FacileStudio/Pastille/dist/fab/bom.csv

Comment | Designator | Footprint | LCSC Part # | Manufacturer Part
ESP32-S3-MINI-1-N4R2 | U_ESP32_S3 | custom | C3013941 | ESP32-S3-MINI-1-N4R2
10kΩ | R_BOOT R_CHG_PU R_PU | res0402 | C25744 | RC0402FR-0710KL
1uF | C_HAP C_HAP_REG C_LCD C_MIC_BULK C_PU | cap0402_nonpolarized | C52923 | GRM155R61A105KE15D
100nF | C_AMP_HF C_BATT_SENSE C_MCU_1 C_MIC | cap0402_nonpolarized | C307331 | GRM155R71C104KA88D
22uF | C_MCU_BULK | cap0603_nonpolarized |  | GRM188R61A226ME15D
TYPE-C 16PIN 2MD(073) | J_USB | custom | C2765186 | TYPE-C 16PIN 2MD(073)
SMF5.0A | D_TVS | smf |  | SMF5.0A
5.1kΩ | R_CC1 R_CC2 | res0402 | C25905 | RC0402FR-075K1L
USBLC6-2SC6 | U_ESD | sot23_6 | C7519 | USBLC6-2SC6
TP4056-42-ESOP8 | U_CHG | soic8_thermalpad2.4x3.1mm | C16581 | TP4056-42-ESOP8
10uF | C_AMP C_BAT C_VBUS | cap0402_nonpolarized |  | GRM155R60J106ME15D
18kΩ | R_PROG | res0402 | C138044 | RC0402FR-0718KL
SM02B-SRSS-TB(LF)(SN) | J_BAT | custom | C160402 | SM02B-SRSS-TB(LF)(SN)
1MΩ | R_BATT_BOT R_BATT_TOP | res0402 |  | RC0402FR-071ML
1N5819WS | D_SYS | sod323 |  | 1N5819WS
AO3401A | Q_PATH | sot23 | C15127 | AO3401A
100kΩ | R_AMP_SD R_BL_PD R_MIC_PD R_PATH_G | res0402 |  | RC0402FR-07100KL
4.7uF | C_SYS | cap0603_nonpolarized | C19666 | GRM188R61A475KE15D
RT9080-33GJ5 | U_LDO | sot23_5 | C841192 | RT9080-33GJ5
10uF | C_LDO_OUT | cap0603_nonpolarized | C19702 | GRM188R61A106KE69D
SPH0645LM4H-B | U_MIC | custom |  | SPH0645LM4H-B
MAX98357AETE+ | U_AMP | qfn16_w3.8_h3.8_p0.5_pw0.25_pl0.8_thermalpad1.23x1.23mm |  | MAX98357AETE+
FH34SRJ-12S-0.5SH(50) | J_LCD | custom | C424659 | FH34SRJ-12S-0.5SH(50)
AO3400A | Q_BL | sot23 | C20917 | AO3400A
10Ω | R_BL | res0402 |  | RC0402FR-0710RL
510Ω | R_TOUCH | res0402 |  | RC0402FR-07510RL
DRV2605LDGSR | U_HAP | msop10 |  | DRV2605LDGSR
4.7kΩ | R_SCL R_SDA | res0402 | C25900 | RC0402FR-074K7L
