FacileStudio/Pastille/bodies/lra.step

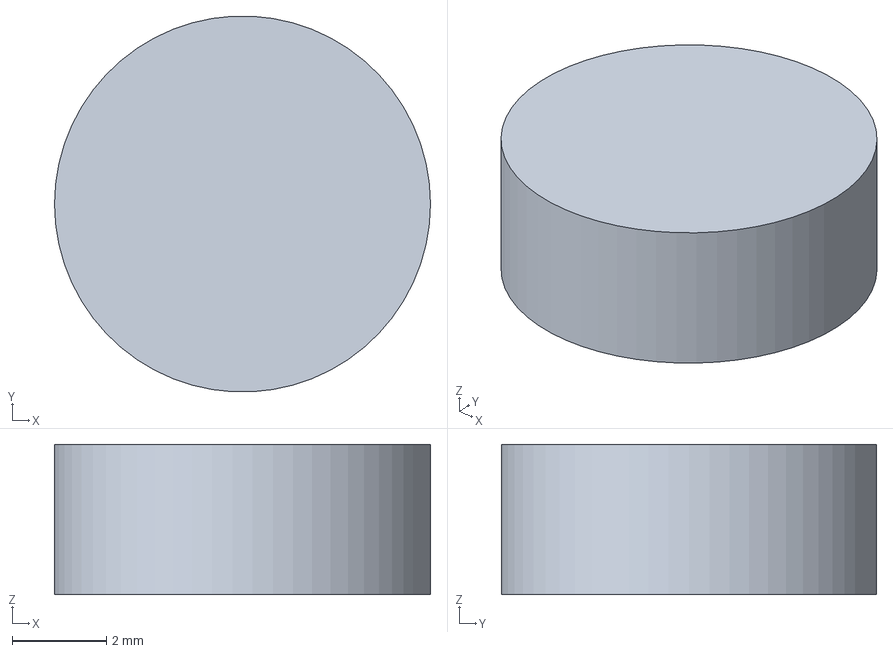
[picture p4: CAD file, 2026-11-06]
bodies/lra.step
8.00 x 7.99 x 3.20 mm
