FacileStudio/Pastille/dist/cad/board.step

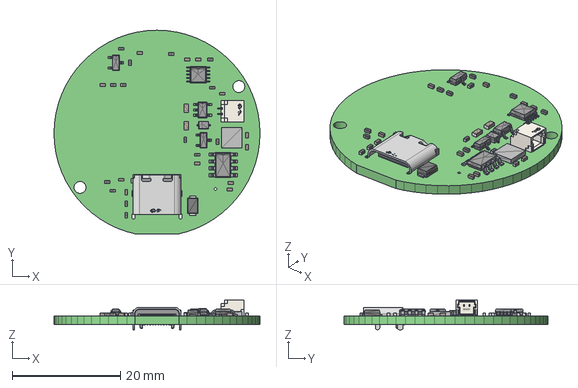
[picture p5: CAD file, 2026-11-04]
dist/cad/board.step
38.0 x 37.6 x 5.48 mm
