FacileStudio/Pastille/bodies/front_bezel.step

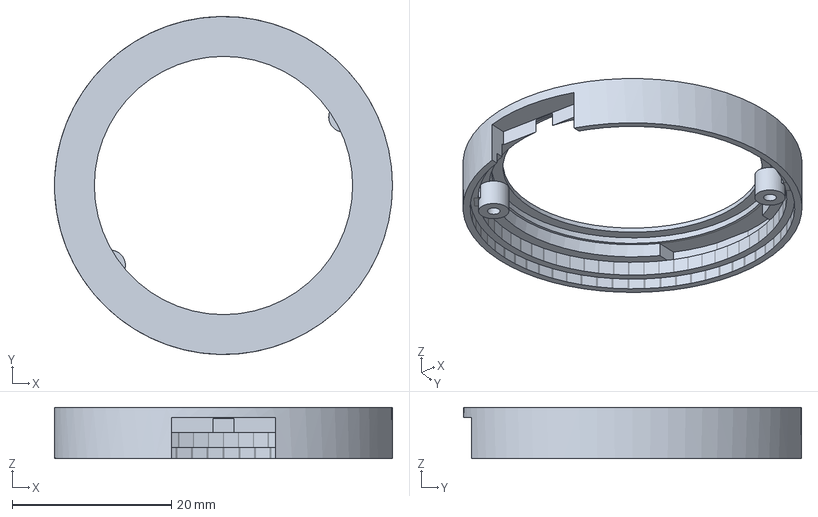
[picture p6: CAD file, 2026-11-06]
bodies/front_bezel.step
42.4 x 42.4 x 6.40 mm
