FacileStudio/Pastille/bodies/lcd.step

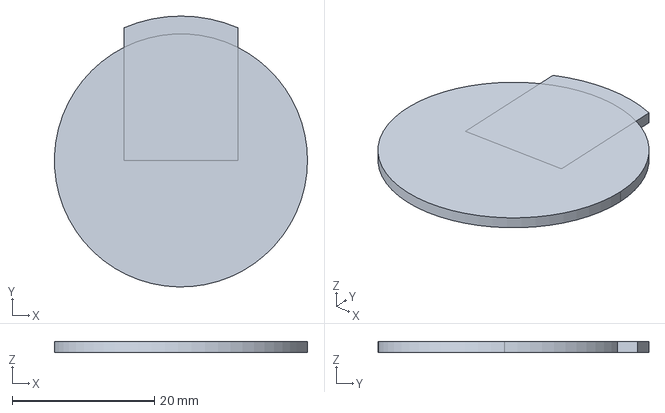
[picture p7: CAD file, 2026-11-06]
bodies/lcd.step
35.6 x 38.1 x 1.50 mm
