FacileStudio/Pastille/bodies/battery.step

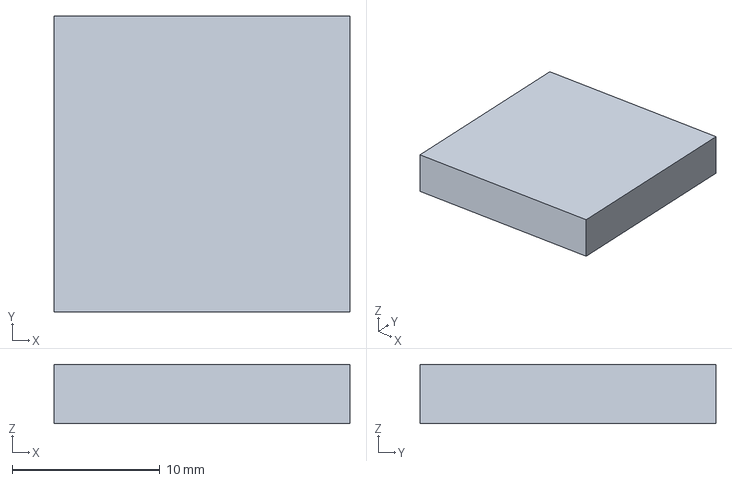
[picture p8: CAD file, 2026-11-06]
bodies/battery.step
20.0 x 20.0 x 4.00 mm
