FacileStudio/Pastille/bodies/back_shell.step

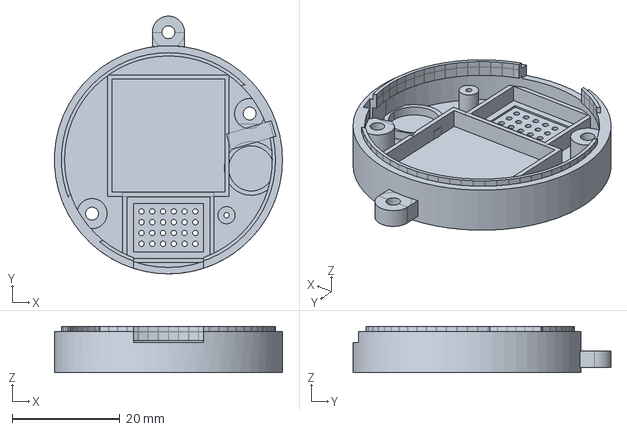
[picture p9: CAD file, 2026-11-06]
bodies/back_shell.step
42.4 x 47.9 x 8.60 mm
