FacileStudio/Pastille/bodies/speaker.step

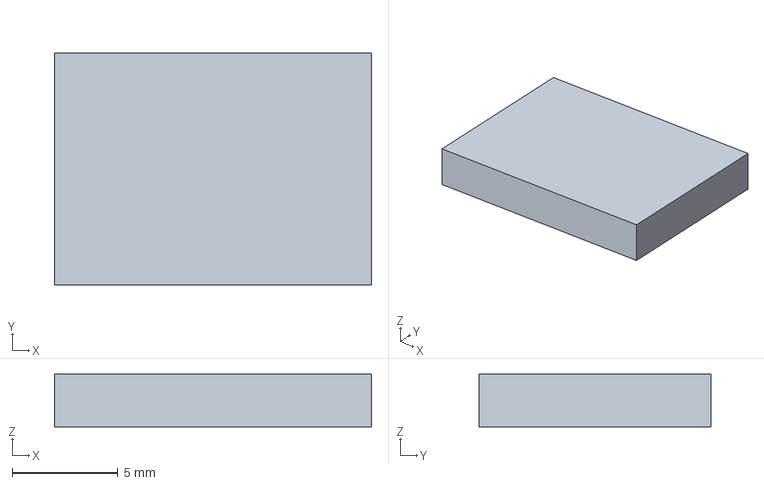
[picture p10: CAD file, 2026-11-06]
bodies/speaker.step
15.0 x 11.0 x 2.50 mm
