FacileStudio/Pastille/bodies/lens.step

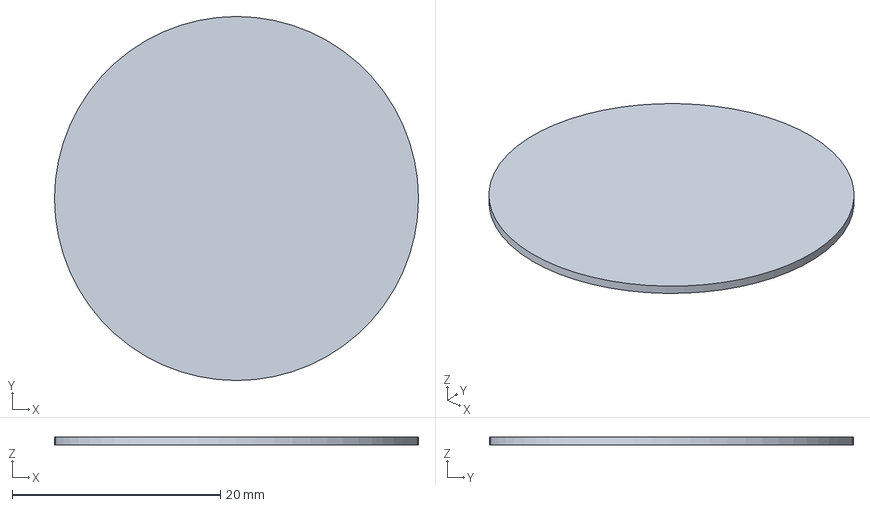
[picture p11: CAD file, 2026-11-06]
bodies/lens.step
35.0 x 35.0 x 0.8 mm
