FacileStudio/Pastille/(list of files, cad)

Other CAD files:
bodies/back_shell.stl
bodies/battery.stl
bodies/front_bezel.stl
bodies/lcd.stl
bodies/lens.stl
bodies/lra.stl
bodies/speaker.stl
