FacileStudio/Pastille/(commit log)

2026-11-04 feat(hardware): implement pastille modular subcircuits and electrical linting
    [pastille_case.step, pastille_case.stl]
2026-11-04 feat: release v0.2.0 with production hardware, firmware, and muse landing page
    [pastille_case.step, pastille_case.stl]
2026-11-04 feat(hardware): circular 38mm black pcb, 3d usb-c footprint, and release v0.2.2
    [pastille_case.step, pastille_case.stl]
2026-11-04 fix(web): cache-bust 3d pcb and enclosure glb urls
2026-11-04 fix(hardware): correct charger, amp and haptic footprints and populate bom
    [pastille_case.step, pastille_case.stl]
2026-11-04 ci: fail the release when an attached asset is missing
2026-11-04 feat(web): show three devices with solar icons in the connectivity diagram
2026-11-04 fix(hardware): route the board, fix the mic footprint and charge current
2026-11-04 feat(hardware): add the printable enclosure and assembly check
    [back_shell.step, back_shell.stl, battery.step, battery.stl, board.step, front_bezel.step, front_bezel.stl, lcd.step]
2026-11-04 docs: document the enclosure, battery and stack
2026-11-04 ci: attach printable bodies and fab files to releases
2026-11-04 perf(web): lazy-load the board viewer and render it on demand
    The viewer now mounts near the viewport, renders only while the camera moves, and keeps orbit and wheel zoom off until the visitor taps Explore in 3D, so the page scrolls on touch screens. Toggles grow to 44 px on coarse pointers, mode buttons wait for the first model, and the error copy no longer blames WebGL. The release version lives in one constant.
2026-11-04 fix(web): render both topology layouts and label the example devices
    Both SVG layouts render at build time and CSS picks one, so phones no longer shift after hydration. The direct Wi-Fi paths use an .off class instead of colliding with Tailwind's hidden utility, so they fade. The cycle pauses while the card is hovered, focused or off screen. The copy says the speaker and headset are example BOHS-01 devices.
2026-11-04 fix(web): harden the disassembly against load failures and churn
    A failed ScrollTrigger import no longer surfaces as an unhandled rejection. A renderer that fails to start frees the loaded model. The screen overlay stays mounted and hides with visibility instead of remounting on every scroll. The pointer-tracking sentence only shows when motion is on.
2026-11-04 fix(web): source the comparison and label design targets
    Every Omi and Rabbit R1 figure now comes from the vendor's page or a review, linked under the table. The unsourced BOM, standby and wake latency rows are gone, and Omi is no longer merged with Friend. Pastille battery and wake figures say they are targets, the screen redraws at 30 FPS as the firmware does, and the battery card reads from BATTERY.
2026-11-04 fix(web): drop the display frame rate the firmware no longer meets
    The display task now waits 100 ms per frame, so neither 60 nor 30 FPS holds.
2026-11-04 fix(hardware): write step bodies with a fixed timestamp
    [back_shell.step, battery.step, front_bezel.step, lcd.step, lens.step, lra.step, speaker.step]
2026-11-04 docs: regenerate the board render from the current pastille.glb
2026-11-04 fix(firmware): answer every request and bind pairing to its link
    - share the JSON-RPC envelope and error mapping between 0x02 and 0x03;
    every request with an id now gets a result or an error, notifications
    are ignored, and ids are limited to strings of 64 bytes, numbers or null
    - drop 0x03 frames received over WSS instead of answering them
    - bind the tap window to the BLE connection that opened it, clear it on
    disconnect, reject every 0x03 request on an unencrypted link, and stop
    a repeated prov.identify from resetting an open window
    - keep the latest avatar face in a signal and hand haptic requests to the
    motor through another
    - accept only 644-byte audio frames with zero reserved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
    [audio.rs, battery.rs, ble.rs, ble_link.rs, events.rs, haptic.rs, link.rs, main.rs]
2026-11-04 feat(firmware): boot on the esp32-s3 with esp-hal 1.2 and esp-rtos
    Move to esp-hal 1.2.2, esp-rtos 0.4 (Embassy), embassy-executor 0.10,
    embassy-time 0.5, embassy-sync 0.8, esp-alloc 0.11, esp-backtrace 0.20,
    esp-println 0.18 and esp-bootloader-esp-idf 0.6, built with espup's esp
    toolchain. The device entry point sets up a 48 KiB internal-RAM heap,
    the esp-rtos time driver and these tasks:
    - USB CDC transport on USB Serial/JTAG with u16be stream framing
    - the protocol loop, driven by inbound frames and real elapsed time
    - GC9A01 avatar display through mipidsi
    - DRV2605L haptic pulses in open-loop RTP mode
    - battery and charger sampling with low-battery alerts
    Every GPIO comes from pins.rs.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
2026-11-04 feat(firmware): pair over ble, keep settings in flash, read the touch pad
    Move to esp-radio 1.0.0-beta.1 (BLE controller) with trouble-host 0.7,
    which match esp-hal 1.2. The device now runs:
    - a GATT server with the BOHS-01 service, B001 info record and
    u16be-framed B002/B003/B004 streams, opcode checked per characteristic
    - advertising with the 6-byte service data, refreshed on state changes
    - LE Secure Connections with numeric comparison confirmed by a tap;
    B004 needs an encrypted link and 0x03 needs a bonded key
    - prov.state notifications, the identify pulse and pairing ring
    - a CRC-checked settings record in two flash slots holding the config
    and one bond, loaded at boot
    - capacit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
2026-11-04 feat(firmware): reach the gateway over wi-fi and a tls websocket
    Wi-Fi station from the stored config, embassy-net 0.9 with DHCP and
    DNS, embedded-tls 0.19 (TLS 1.3, AES-128-GCM) and a bohs.v1 WebSocket
    client sending the bearer token, one frame per binary message, with
    ping keepalive and reconnect backoff from 1 s to 60 s. The server chain
    must reach one of four pinned roots (ISRG X1, ISRG X2, GTS R4,
    GlobalSign R1) and name the gateway host; validity dates are not
    checked because the device has no trusted clock.
2026-11-04 build(firmware): flash a 4 mb image with the settings partition
    [partitions.csv]
2026-11-04 docs: list what the v0.4.0 firmware runs on the device
2026-11-04 build(hardware): pin tscircuit and add fflate for the fab files
2026-11-04 feat(hardware): move to the esp32-s3-mini-1 module and smt-only parts
    Replace the bare ESP32-S3R8 with an ESP32-S3-MINI-1-N4R2 on its datasheet land pattern, antenna at the -X edge over an all-layer keep-out. Add the EN RC, 22 uF decoupling and boot test pads in place of SW_BOOT. Use a 600 mA RT9080 LDO, a P-MOSFET power path, a 12-pin FH34SRJ FPC with a switched backlight, a USBLC6 ESD array, a JST SH battery header and bottom wire pads for the speaker and LRA. Charge at 67 mA, set the amp gain to 6 dB, widen power and ground traces. GPIO numbers are unchanged.
2026-11-04 fix(hardware): fit the case to the smt board at 14 mm
    Take the LCD height from the real USB-C shell, move the cell, speaker and LRA clear of the USB-C tails and the new screw holes, widen the counterbores, recess the mic port and fuse the bezel bosses with the panel shoulder.
    [back_shell.step, back_shell.stl, battery.step, battery.stl, front_bezel.step, front_bezel.stl, lcd.step, lcd.stl]
2026-11-04 feat(hardware): write the ground pour, bom and cpl into the fab files
    [board.step, bom.csv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]
2026-11-04 fix(hardware): turn the board glb so the silkscreen reads
2026-11-04 fix(hardware): list real part numbers and prices in the bom
2026-11-04 docs: describe the v0.4.0 module, power path, fab files and battery budget
2026-11-04 fix(web): match battery, size, cost and module copy to the v0.4.0 board
2026-11-04 feat(firmware): stream full-duplex audio and set the clock over sntp
    - SPH0645 microphone on I2S0 with DMA: 32-bit slots at 16 kHz, the
    one-bit-late latch undone, DC blocked, RMS VAD with a 300 ms hangover
    - upstream 0x01 frames only in the full-duplex stream state, with VAD
    and EOU flags and a gap-free sequence; the mic clock stops in sleep
    - MAX98357A on I2S1 with DMA behind an 80 ms jitter buffer that plays
    silence for late frames; SD_MODE shuts the amp down after 200 ms idle
    - SNTP over Wi-Fi with a build floor; TLS now checks certificate dates
    and no WSS session opens before the clock is set
    - capability bits back to 0x0F; tap timestamps use wall time when known
    [audio.rs, ble.rs, clock.rs, jitter.rs, link.rs, main.rs, mic.rs, mod.rs]
2026-11-04 feat(firmware): request 2m phy, long packets and short intervals for ble audio
    [mod.rs, session.rs]
2026-11-04 feat(firmware): encrypt the settings partition once flash encryption is on
    [partitions.csv]
2026-11-04 fix: enrich 3d pcb, black lcd, stacked cards and concentric header
2026-11-04 fix(ci): normalize front bezel step coordinate and ignore point precision
    [front_bezel.step]
2026-11-04 fix(web): add card stacking shadows and fade in glass lens
2026-11-05 fix(web): shorten battery cell and drop step numbers
2026-11-05 fix(web): register solar cart and send glyphs for pre-order buttons
2026-11-06 fix(hardware): round every step and stl float instead of one literal
    Reprint each STEP real at 10 significant digits and snap binary STL floats to a 1e-4 mm grid, so last-bit float noise cannot change the committed bodies. Drops the hand-patched front bezel literal.
    [back_shell.step, back_shell.stl, battery.step, battery.stl, front_bezel.step, front_bezel.stl, lcd.step, lcd.stl]
2026-11-06 ci: pin bun, lock cargo and restore the strict bodies check
    Pin bun 1.4.2 in mise.toml and every CI job, and fail when they disagree. Run cargo test and clippy with --locked. Rebuild the bodies and fail on any diff or new file under bodies, STEP and STL alike, with no -I filter.
2026-11-06 fix(web): tighten the hero copy and use the duotone cart icon
2026-11-06 fix(web): place the board overlay parts where the circuit puts them
2026-11-06 ci: compare stl bodies by geometry and keep step byte-strict
2026-11-07 docs(spec): split bohs-01 into a core and charm and field profiles
    Adds the field profile for fixed mains devices, code pairing for devices with no BLE link, the 0x10 switch capability with switch.set and switch.get, the <device>__<tool> naming the gateway shows the model, and a 5 s tool bound.
2026-11-07 feat(examples): add bohs-switch, a raspberry pi lamp switch for bulle
    A Rust daemon that pairs with Bulle by a typed code, keeps its token in a 0700 state dir, and answers switch.set and switch.get over the bohs.v1 socket by driving a GPIO line. Ships a Docker cross build for arm64 and armhf, a systemd unit and install script for Raspberry Pi OS, and an rpi-image-gen config and layer for a dedicated Pi 3 image.
2026-11-07 feat(web): adopt muse LandingHeader and LandingFooter
2026-11-07 fix(bohs-switch): add network timeouts, refuse plain-text tokens and restart on install
    [config.rs, display.rs, pairing.rs, session.rs, tests.rs]
2026-11-11 fix(brand): give the head metadata the 42 mm disc size
2026-11-14 feat(web): shorten the landing and add a mise-en-scene hero demo
